adafruit/Adafruit-ADS7830-PCB/Adafruit ADS7830 Breakout PCB.brd

## EAGLE design Adafruit ADS7830 Breakout PCB.brd (2023-11-03)

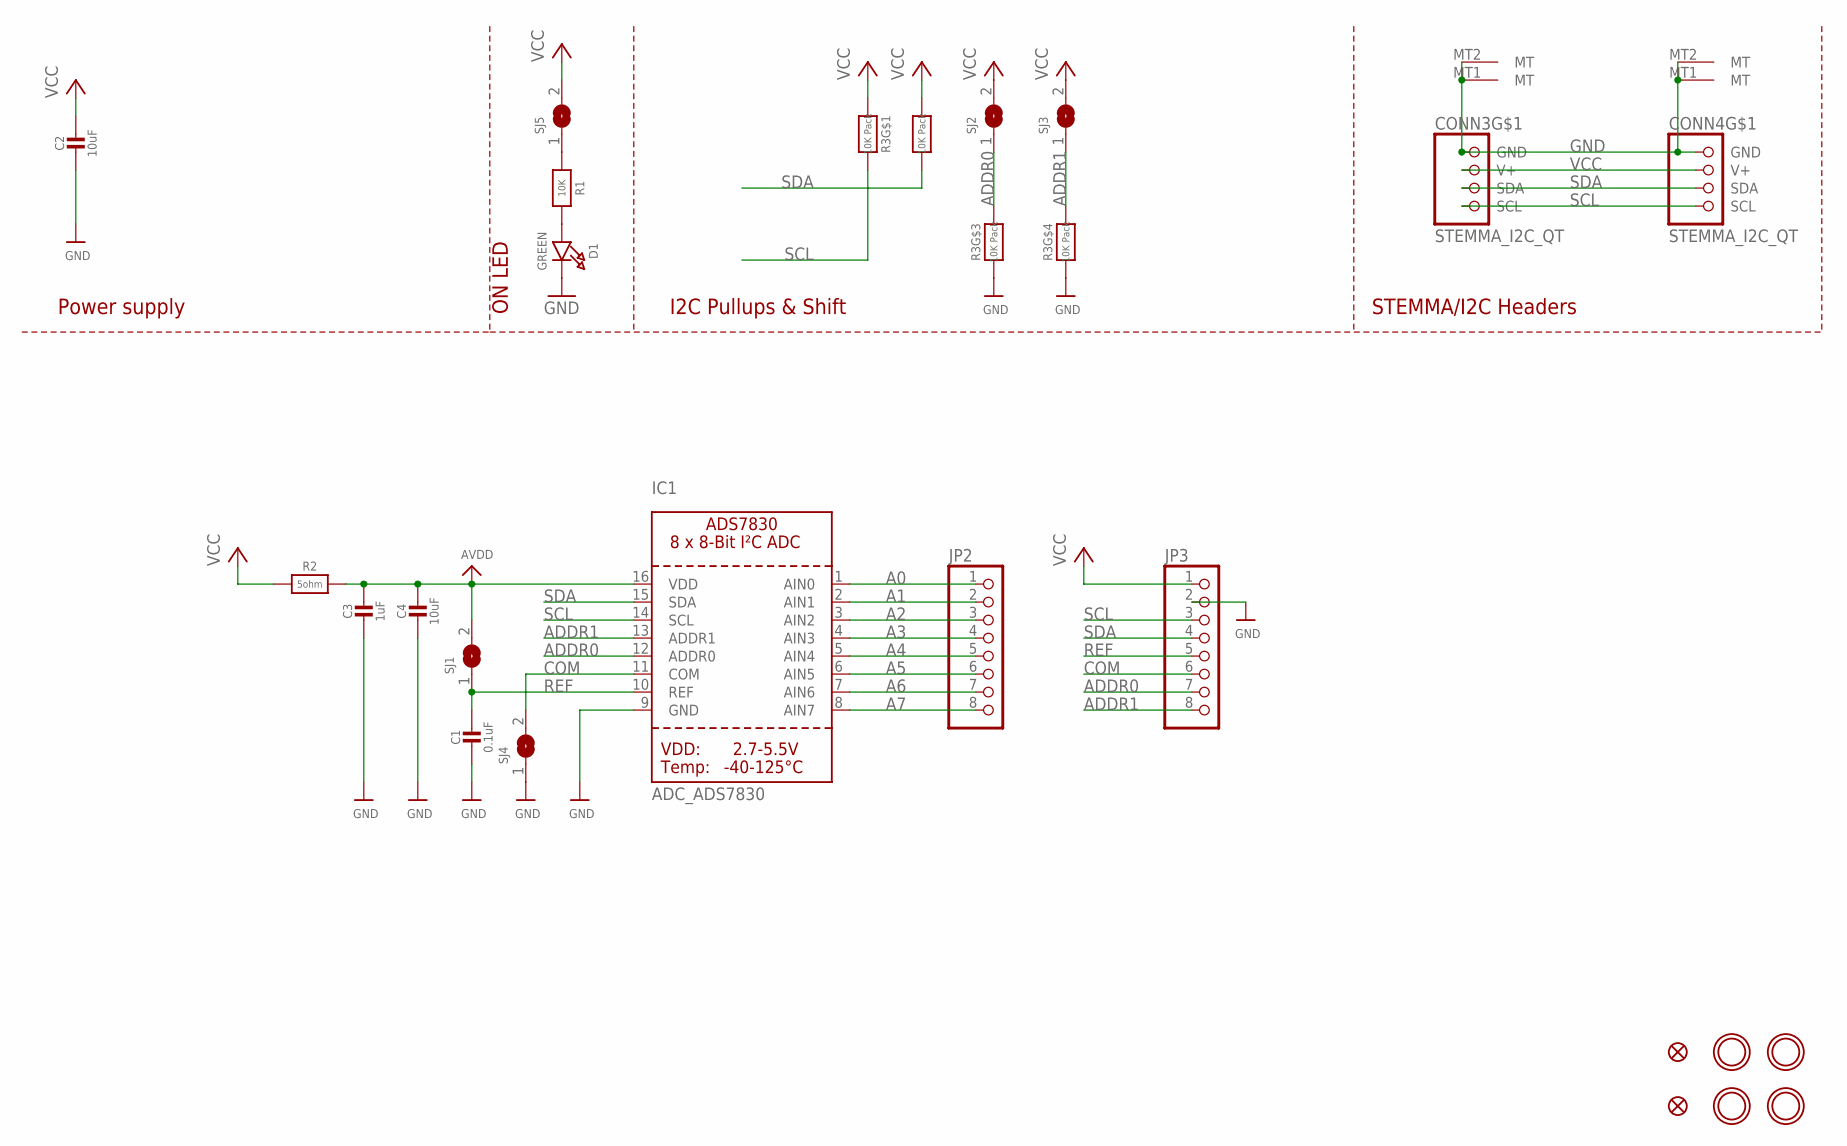
[picture p2: schematic Adafruit ADS7830 Breakout PCB.sch]

Parts:
C1: 0.1uF; 0603-NO
C2, C4: 10uF; 0805-NO
C3: 1uF; 0603-NO
CONN3, CONN4: STEMMA_I2C_QT; JST_SH4
D1: GREEN; CHIPLED_0603_NOOUTLINE
FID3, FID4: FIDUCIAL_1MM
IC1: ADC_ADS7830; TSSOP16
JP2, JP3: HEADER-1X870MIL; 1X08_ROUND_70
R1: 10K; 0603-NO
R2: 5ohm; 0603-NO
R3: 10K Pack; RESPACK_4X0603
SJ1, SJ4, SJ5: SOLDERJUMPERCLOSED; SOLDERJUMPER_CLOSEDWIRE
SJ2, SJ3: SOLDERJUMPER; SOLDERJUMPER_ARROW_NOPASTE
U$1, U$17, U$19, U$21: MOUNTINGHOLE2.5; MOUNTINGHOLE_2.5_PLATED

Connections:
A0: IC1.1 (AIN0), JP2.1
A1: IC1.2 (AIN1), JP2.2
A2: IC1.3 (AIN2), JP2.3
A3: IC1.4 (AIN3), JP2.4
A4: IC1.5 (AIN4), JP2.5
A5: IC1.6 (AIN5), JP2.6
A6: IC1.7 (AIN6), JP2.7
A7: IC1.8 (AIN7), JP2.8
ADDR0: IC1.12 (ADDR0), JP3.7, R3.6 (2), SJ2.1
ADDR1: IC1.13 (ADDR1), JP3.8, R3.5 (2), SJ3.1
AVDD: C3.1, C4.1, IC1.16 (VDD), R2.2, SJ1.2
COM: IC1.11 (COM), JP3.6, SJ4.2
GND: C1.2, C2.2, C3.2, C4.2, CONN3.1 (GND), CONN3.MT1 (MT), CONN3.MT2 (MT), CONN4.1 (GND), CONN4.MT1 (MT), CONN4.MT2 (MT), D1.C, IC1.9 (GND), JP3.2, R3.3 (1), R3.4 (1), SJ4.1
unnamed: D1.A, R1.2
unnamed: R1.1, SJ5.1
REF: C1.1, IC1.10 (REF), JP3.5, SJ1.1
SCL: CONN3.4 (SCL), CONN4.4 (SCL), IC1.14 (SCL), JP3.3, R3.8 (2)
SDA: CONN3.3 (SDA), CONN4.3 (SDA), IC1.15 (SDA), JP3.4, R3.7 (2)
VCC: C2.1, CONN3.2 (V+), CONN4.2 (V+), JP3.1, R2.1, R3.1, R3.2 (1), SJ2.2, SJ3.2, SJ5.2

Notes on the sheet:
I2C Pullups & Shift
STEMMA/I2C Headers
ON LED
Power supply

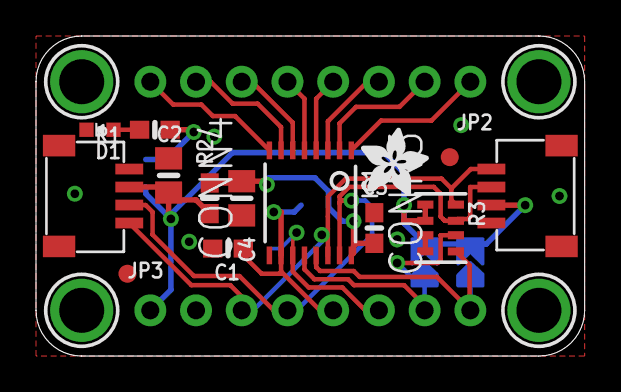
[picture p3: board Adafruit ADS7830 Breakout PCB.brd from above]

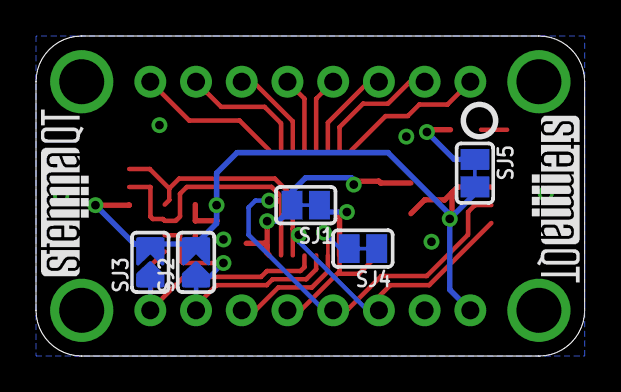
[picture p4: board Adafruit ADS7830 Breakout PCB.brd from below]

Board: 2 copper layers, 30.5 x 17.8 mm, 54 parts (16 on the bottom side), 19 nets.

Other parts of the board:
PLABEL0: PLABEL0
PLABEL1: PLABEL1
PLABEL2: PLABEL2
PLABEL3: PLABEL3
PLABEL4: PLABEL4
PLABEL5: PLABEL5
PLABEL6: PLABEL6
PLABEL7: PLABEL7
PLABEL8: PLABEL8
PLABEL9: PLABEL9
PLABEL10: PLABEL10
PLABEL11: PLABEL11
PLABEL12: PLABEL12
PLABEL13: PLABEL13
PLABEL14: PLABEL14
PLABEL15: PLABEL15
PLABEL16: PLABEL16
PLABEL17: PLABEL17
PLABEL18: PLABEL18
PLABEL19: PLABEL19
PLABEL20: PLABEL20
PLABEL21: PLABEL21
PLABEL22: PLABEL22
PLABEL23: PLABEL23
PLABEL24: PLABEL24
PLABEL25: PLABEL25
U$22: ADAFRUIT_3.5MM
U$25: PCBFEAT-REV-040
U$30, U$31: STEMMAQT
